twenty-seven27/CAN-NODE-BOARD/layout-bottom.png

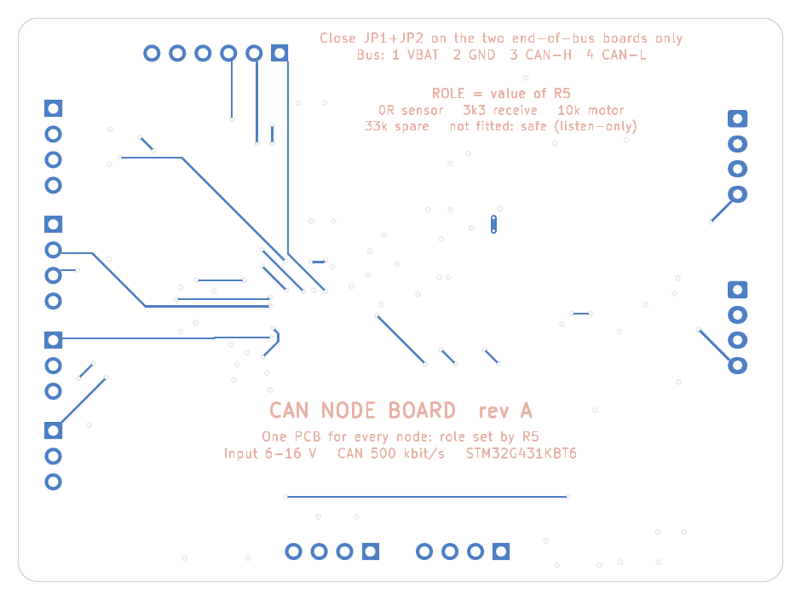
layout-bottom.png
