twenty-seven27/CAN-NODE-BOARD/layout-top.png

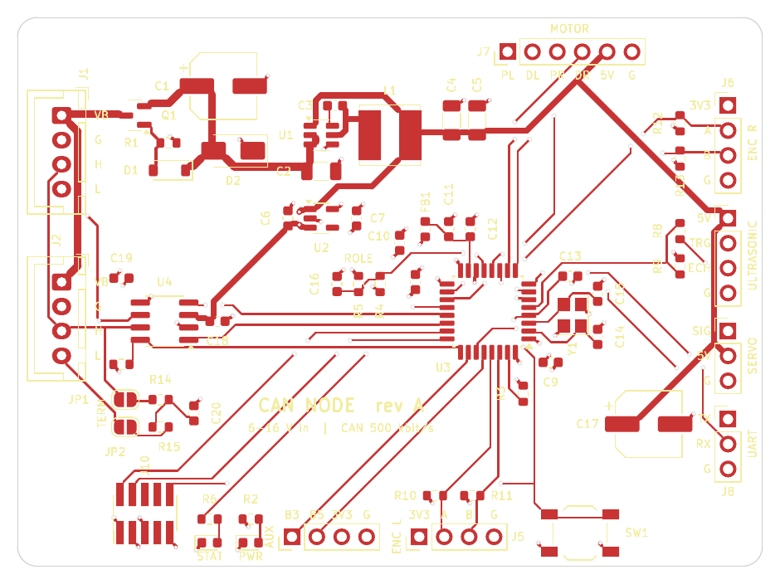
layout-top.png
