twenty-seven27/CAN-NODE-BOARD/schematic.pdf

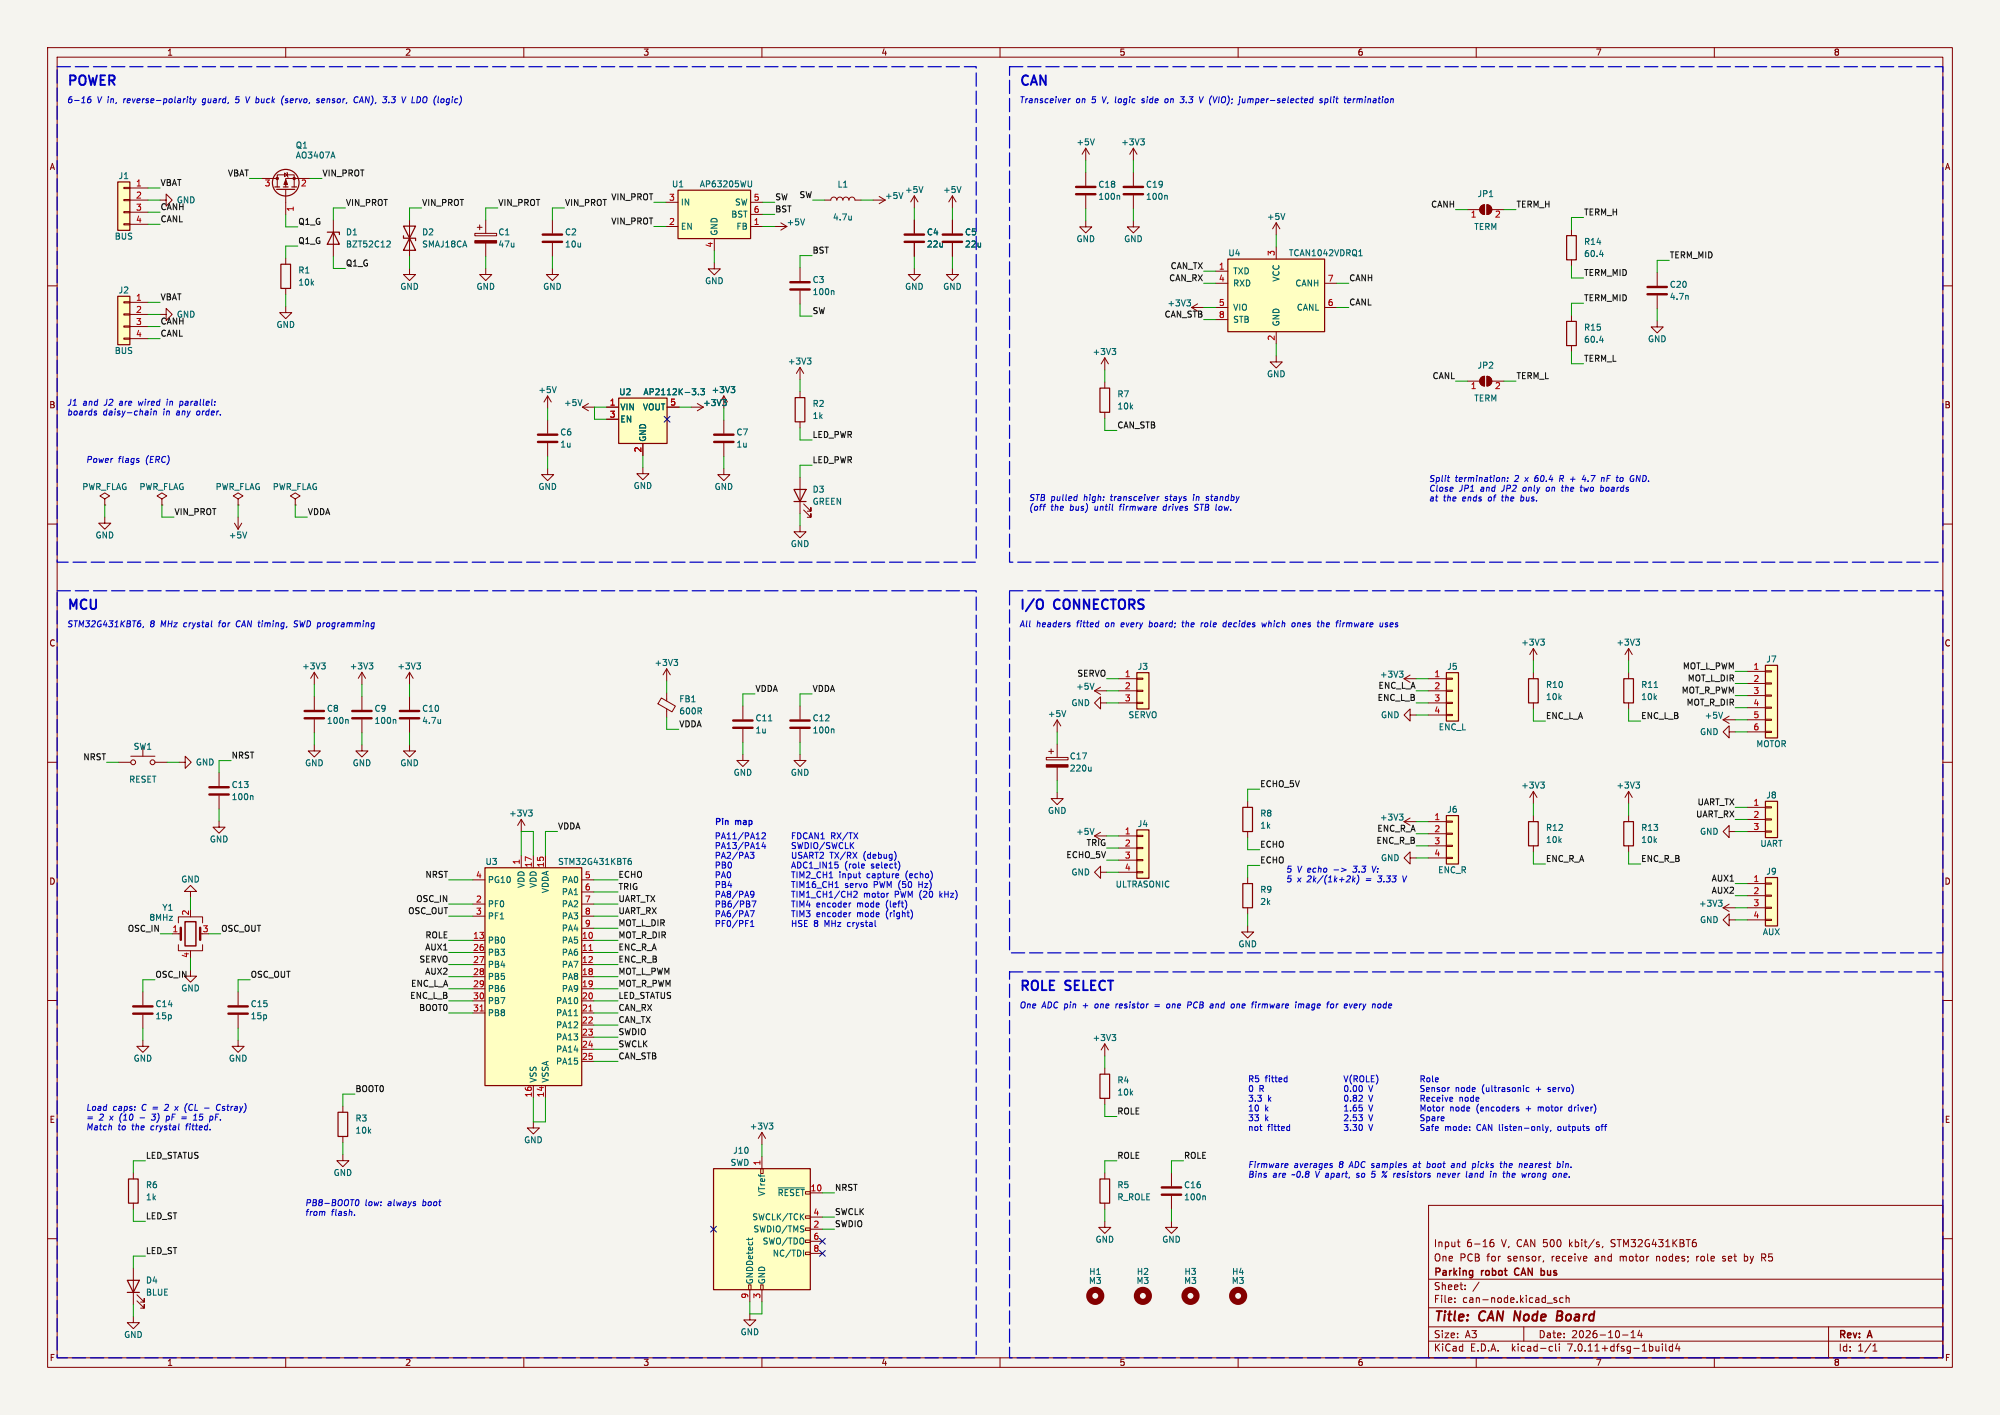
[picture p6: page 1]

3 RXD 4 VIO 5 CANL 6 CANH 7 STB 8 U4 TCAN1042VDRQ1 +3V3 R8

1 PA5 10 PA6 11 PA7 12 PB0 13 VSSA 14 VDDA 15 VSS 16 VDD 17 PA8 18 PA9 19 PF0 2 PA10 20 PA11 21 PA12 22 PA13 23 PA14 24 PA15 25 PB3 26 PB4 27 PB5 28 PB6 29 PF1 3 PB7 30 PB8 31 PG10 4 PA0 5 PA1 6 PA2 7 PA3 8 PA4 9 U3 STM32G431KBT6 GND

Load caps: C = 2 x (CL - Cstray) = 2 x (10 - 3) pF = 15 pF. Match to the crystal fitted.

3 SWCLK/TCK 4 SWO/TDO 6 NC/TDI 8 GNDDetect 9

Id: 1/1 Title: CAN Node Board
