twenty-seven27/CAN-NODE-BOARD/can-node.kicad_pcb

## KiCad design can-node.kicad_pcb (2026-10-15)

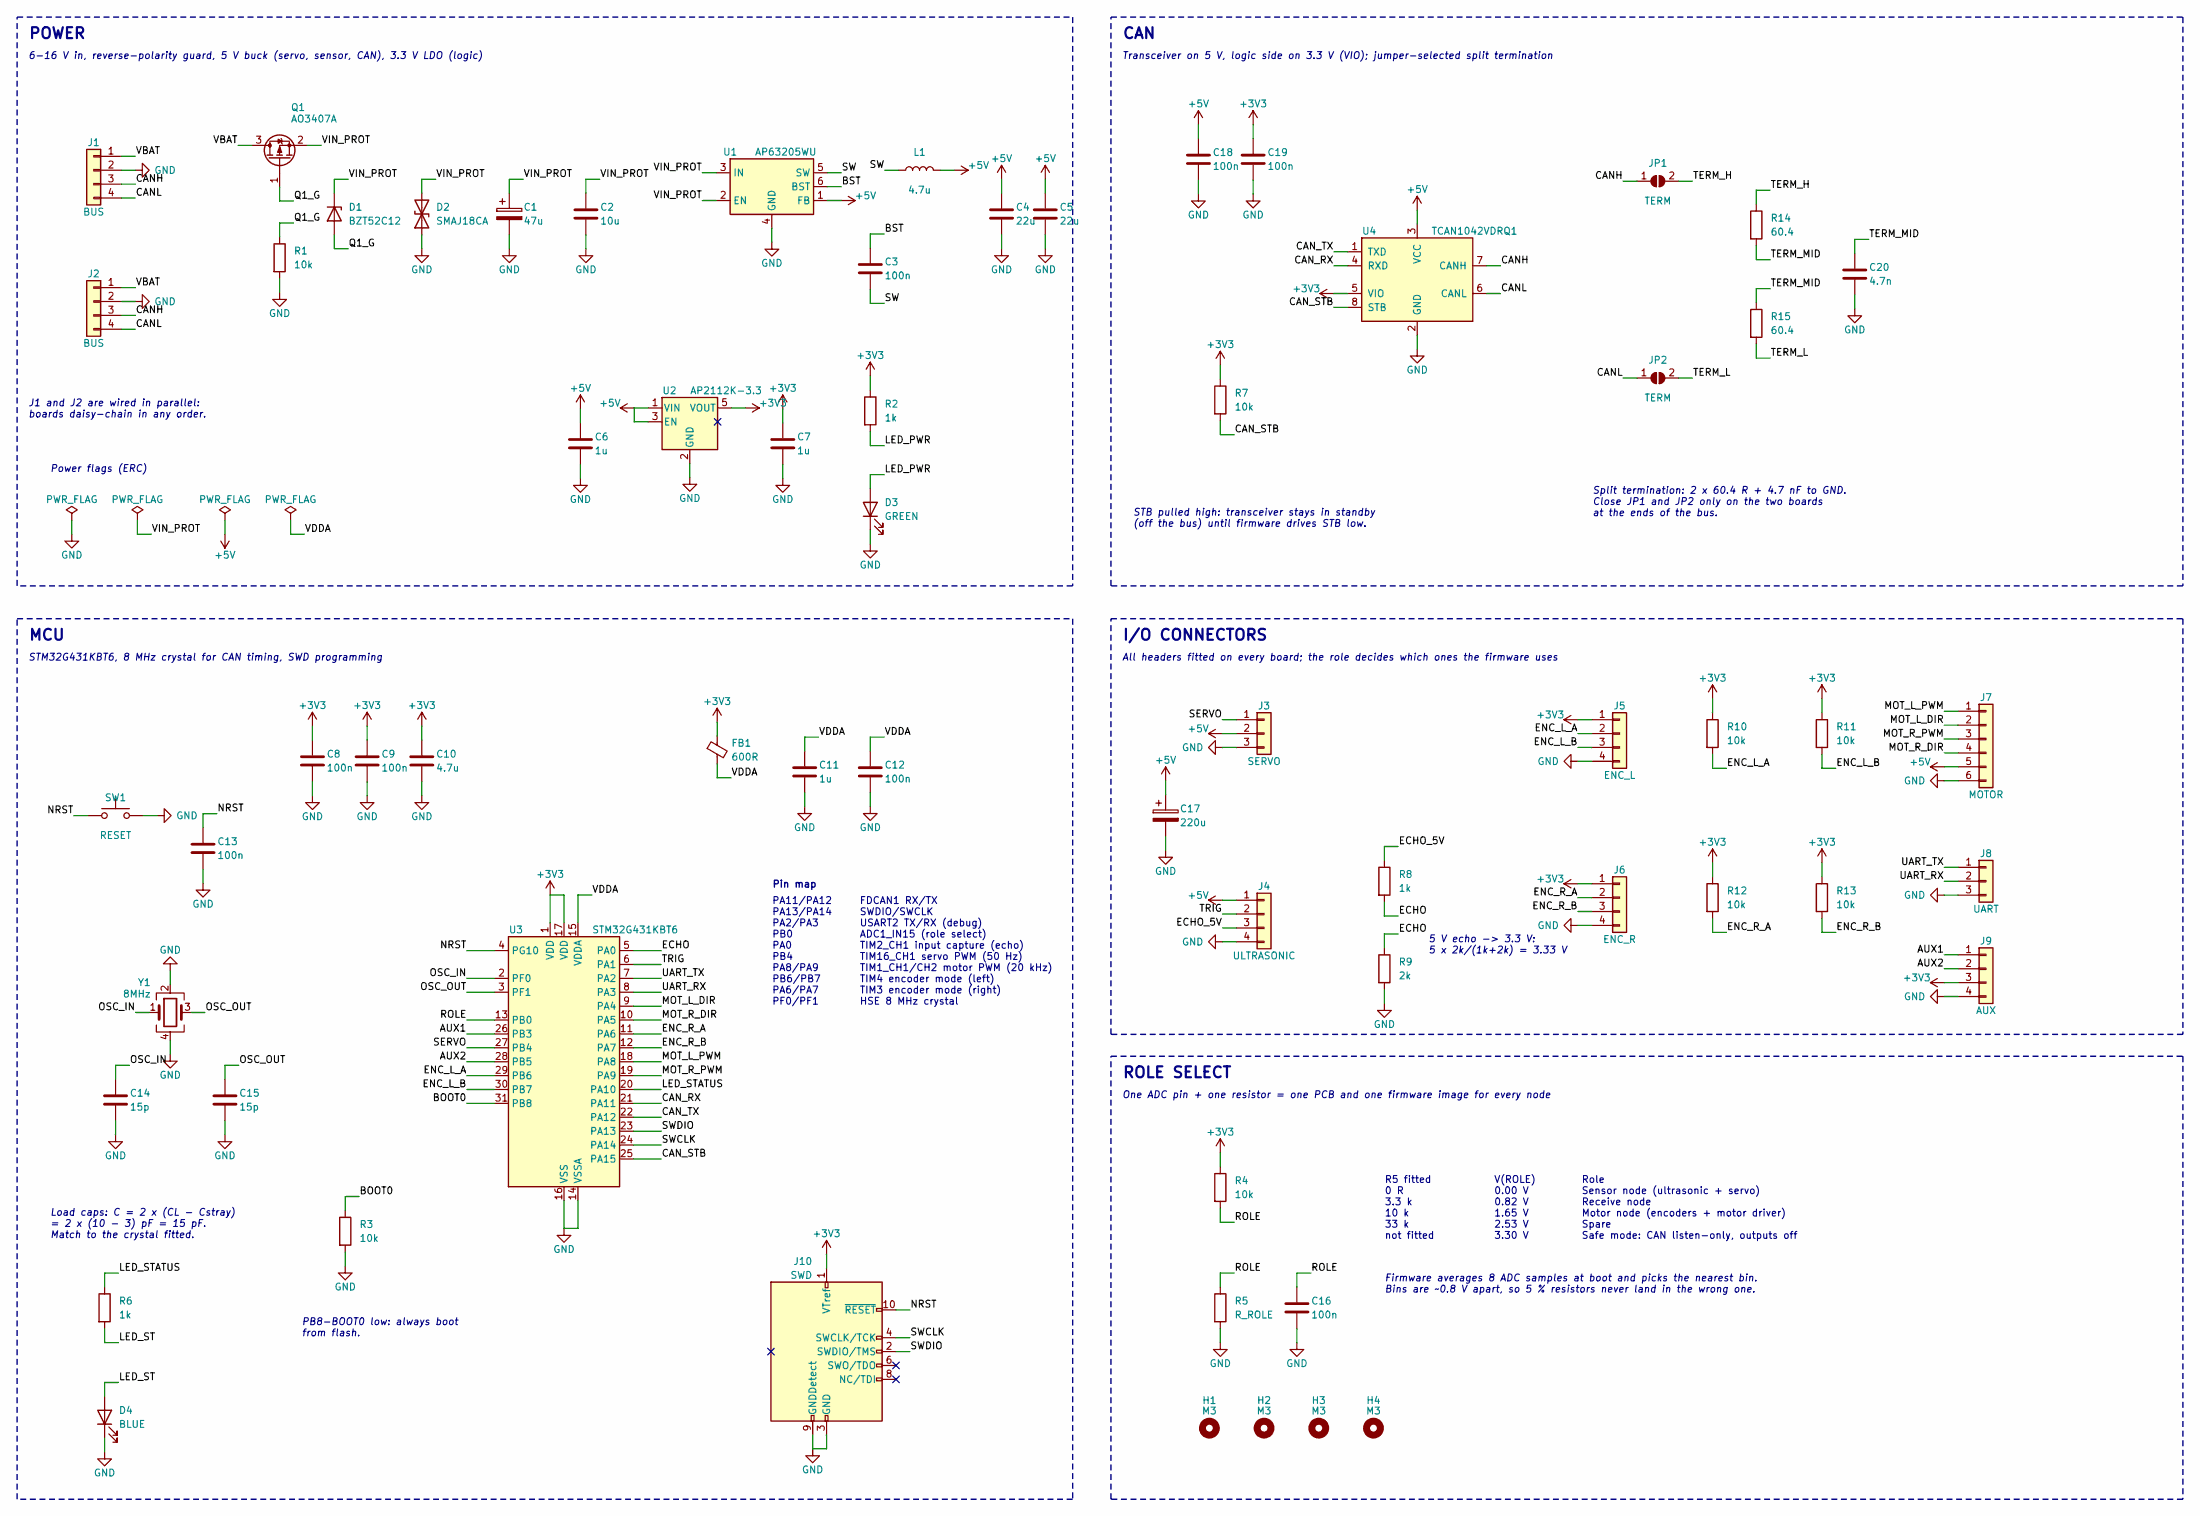
[picture p7: schematic can-node.kicad_sch, CAN Node Board]

Parts:
C1: 47u; CP_Elec_6.3x7.7; MPN Aluminium electrolytic 47 uF 35 V 6.3x7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
C2: 10u; C_1206_3216Metric; MPN X5R 10 uF 35 V 1206
C3, C8, C9, C12, C13, C16, C18, C19: 100n; C_0603_1608Metric; MPN X7R 100 nF 50 V 0603
C4, C5: 22u; C_1206_3216Metric; MPN X5R 22 uF 16 V 1206
C6, C7, C11: 1u; C_0603_1608Metric; MPN X7R 1 uF 16 V 0603
C10: 4.7u; C_0603_1608Metric; MPN X5R 4.7 uF 10 V 0603
C14, C15: 15p; C_0603_1608Metric; MPN C0G 15 pF 50 V 0603
C17: 220u; CP_Elec_6.3x7.7; MPN Aluminium electrolytic 220 uF 10 V 6.3x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
C20: 4.7n; C_0603_1608Metric; MPN C0G 4.7 nF 50 V 0603
D1: BZT52C12; D_SOD-123; MPN BZT52C12-7-F
D2: SMAJ18CA; D_SMA; MPN SMAJ18CA
D3: GREEN; LED_0603_1608Metric; MPN Green LED 0603
D4: BLUE; LED_0603_1608Metric; MPN Blue LED 0603
FB1: 600R; L_0603_1608Metric; MPN Murata BLM18AG601SN1D (600 R at 100 MHz)
H1, H2, H3, H4: M3; MountingHole_3.2mm_M3
J1, J2: BUS; JST_XH_B4B-XH-A_1x04_P2.50mm_Vertical; MPN JST B4B-XH-A
J3: SERVO; PinHeader_1x03_P2.54mm_Vertical; MPN 1x3 2.54 mm header
J4: ULTRASONIC; PinHeader_1x04_P2.54mm_Vertical; MPN 1x4 2.54 mm header
J5: ENC_L; PinHeader_1x04_P2.54mm_Vertical; MPN 1x4 2.54 mm header
J6: ENC_R; PinHeader_1x04_P2.54mm_Vertical; MPN 1x4 2.54 mm header
J7: MOTOR; PinHeader_1x06_P2.54mm_Vertical; MPN 1x6 2.54 mm header
J8: UART; PinHeader_1x03_P2.54mm_Vertical; MPN 1x3 2.54 mm header
J9: AUX; PinHeader_1x04_P2.54mm_Vertical; MPN 1x4 2.54 mm header
J10: SWD; PinHeader_2x05_P1.27mm_Vertical_SMD; MPN 2x5 1.27 mm SMD header (Cortex debug)
JP1, JP2: TERM; SolderJumper-2_P1.3mm_Open_RoundedPad1.0x1.5mm
L1: 4.7u; L_Bourns_SRN6045TA; MPN Bourns SRN6045TA-4R7M
Q1: AO3407A; SOT-23; MPN AO3407A
R1, R3, R7, R10, R11, R12, R13: 10k; R_0603_1608Metric
R2, R6, R8: 1k; R_0603_1608Metric
R4: 10k; R_0603_1608Metric; MPN 10k 1% 0603
R5: R_ROLE; R_0603_1608Metric; MPN per role table
R9: 2k; R_0603_1608Metric
R14, R15: 60.4; R_0603_1608Metric; MPN 60.4 ohm 1% 0603
SW1: RESET; SW_SPST_TL3342; MPN E-Switch TL3342F160QG
U1: AP63205WU; TSOT-23-6; MPN AP63205WU-7
U2: AP2112K-3.3; SOT-23-5; MPN AP2112K-3.3TRG1
U3: STM32G431KBT6; LQFP-32_7x7mm_P0.8mm; MPN STM32G431KBT6
U4: TCAN1042VDRQ1; SOIC-8_3.9x4.9mm_P1.27mm; MPN TCAN1042VDRQ1
Y1: 8MHz; Crystal_SMD_3225-4Pin_3.2x2.5mm; MPN 8 MHz 3225 crystal, CL = 10 pF, +/-20 p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

Connections:
+3V3: C7.1, C8.1, C9.1, C10.1, C19.1, FB1.1, J5.1, J6.1, J9.3, J10.1 (VTref), R2.1, R4.1, R7.1, R10.1, R11.1, R12.1, R13.1, U2.5 (VOUT), U3.1 (VDD), U3.17 (VDD), U4.5 (VIO)
+5V: C4.1, C5.1, C6.1, C17.1, C18.1, J3.2, J4.1, J7.5, L1.2, U1.1 (FB), U2.1 (VIN), U2.3 (EN), U4.3 (VCC)
/AUX1: J9.1, U3.26 (PB3)
/AUX2: J9.2, U3.28 (PB5)
/BOOT0: R3.1, U3.31 (PB8)
/BST: C3.1, U1.6 (BST)
/CANH: J1.3, J2.3, JP1.1 (A), U4.7 (CANH)
/CANL: J1.4, J2.4, JP2.1 (A), U4.6 (CANL)
/CAN_RX: U3.21 (PA11), U4.4 (RXD)
/CAN_STB: R7.2, U3.25 (PA15), U4.8 (STB)
/CAN_TX: U3.22 (PA12), U4.1 (TXD)
/ECHO: R8.2, R9.1, U3.5 (PA0)
/ECHO_5V: J4.3, R8.1
/ENC_L_A: J5.2, R10.2, U3.29 (PB6)
/ENC_L_B: J5.3, R11.2, U3.30 (PB7)
/ENC_R_A: J6.2, R12.2, U3.11 (PA6)
/ENC_R_B: J6.3, R13.2, U3.12 (PA7)
/LED_PWR: D3.2 (A), R2.2
/LED_ST: D4.2 (A), R6.2
/LED_STATUS: R6.1, U3.20 (PA10)
/MOT_L_DIR: J7.2, U3.9 (PA4)
/MOT_L_PWM: J7.1, U3.18 (PA8)
/MOT_R_DIR: J7.4, U3.10 (PA5)
/MOT_R_PWM: J7.3, U3.19 (PA9)
/NRST: C13.1, J10.10 (~RESET), SW1.1, U3.4 (PG10)
/OSC_IN: C14.1, U3.2 (PF0), Y1.1
/OSC_OUT: C15.1, U3.3 (PF1), Y1.3
/Q1_G: D1.2 (A), Q1.1 (G), R1.1
/ROLE: C16.1, R4.2, R5.1, U3.13 (PB0)
/SERVO: J3.1, U3.27 (PB4)
/SW: C3.2, L1.1, U1.5 (SW)
/SWCLK: J10.4 (SWCLK/TCK), U3.24 (PA14)
/SWDIO: J10.2 (SWDIO/TMS), U3.23 (PA13)
/TERM_H: JP1.2 (B), R14.1
/TERM_L: JP2.2 (B), R15.2
/TERM_MID: C20.1, R14.2, R15.1
/TRIG: J4.2, U3.6 (PA1)
/UART_RX: J8.2, U3.8 (PA3)
/UART_TX: J8.1, U3.7 (PA2)
/VBAT: J1.1, J2.1, Q1.3 (D)
/VDDA: C11.1, C12.1, FB1.2, U3.15 (VDDA)
/VIN_PROT: C1.1, C2.1, D1.1 (K), D2.2 (A2), Q1.2 (S), U1.2 (EN), U1.3 (IN)
GND: C1.2, C2.2, C4.2, C5.2, C6.2, C7.2, C8.2, C9.2, C10.2, C11.2, C12.2, C13.2, C14.2, C15.2, C16.2, C17.2, C18.2, C19.2, C20.2, D2.1 (A1), D3.1 (K), D4.1 (K), J1.2, J2.2, J3.3, J4.4, J5.4, J6.4, J7.6, J8.3, J9.4, J10.3 (GND), J10.5 (GND), J10.9 (GNDDetect), R1.2, R3.2, R5.2, R9.2, SW1.2, U1.4 (GND), U2.2 (GND), U3.14 (VSSA), U3.16 (VSS), U3.32 (VSS), U4.2 (GND), Y1.2, Y1.4

Notes on the sheet:
POWER
6-16 V in, reverse-polarity guard, 5 V buck (servo, sensor, CAN), 3.3 V LDO (logic)
J1 and J2 are wired in parallel: boards daisy-chain in any order.
Power flags (ERC)
CAN
Transceiver on 5 V, logic side on 3.3 V (VIO); jumper-selected split termination
STB pulled high: transceiver stays in standby (off the bus) until firmware drives STB low.
Split termination: 2 x 60.4 R + 4.7 nF to GND. Close JP1 and JP2 only on the two boards at the ends of the bus.
MCU
STM32G431KBT6, 8 MHz crystal for CAN timing, SWD programming
Pin map
PA11/PA12 PA13/PA14 PA2/PA3 PB0 PA0 PB4 PA8/PA9 PB6/PB7 PA6/PA7 PF0/PF1
FDCAN1 RX/TX SWDIO/SWCLK USART2 TX/RX (debug) ADC1_IN15 (role select) TIM2_CH1 input capture (echo) TIM16_CH1 servo PWM (50 Hz) TIM1_CH1/CH2 motor PWM (20 kHz) TIM4 encoder mode (left) TIM3 encoder mode (right) HSE 8 MHz crystal
Load caps: C = 2 x (CL - Cstray) = 2 x (10 - 3) pF = 15 pF. Match to the crystal fitted.
PB8-BOOT0 low: always boot from flash.
I/O CONNECTORS
All headers fitted on every board; the role decides which ones the firmware uses
5 V echo -> 3.3 V: 5 x 2k/(1k+2k) = 3.33 V
ROLE SELECT
One ADC pin + one resistor = one PCB and one firmware image for every node
R5 fitted 0 R 3.3 k 10 k 33 k not fitted
V(ROLE) 0.00 V 0.82 V 1.65 V 2.53 V 3.30 V
Role Sensor node (ultrasonic + servo) Receive node Motor node (encoders + motor driver) Spare Safe mode: CAN listen-only, outputs off
Firmware averages 8 ADC samples at boot and picks the nearest bin. Bins are ~0.8 V apart, so 5 % resistors never land in the wrong one.

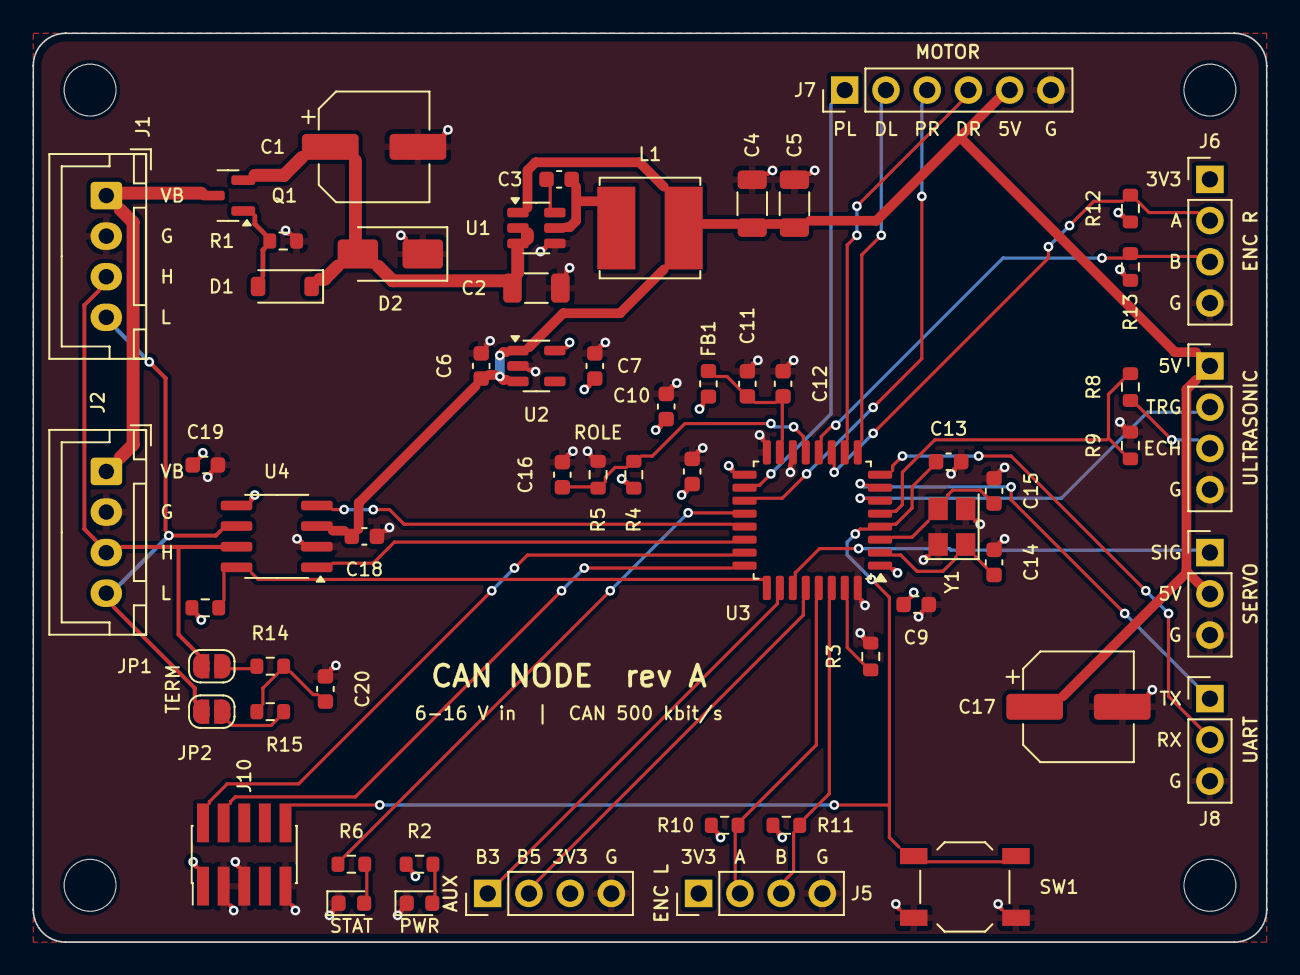
[picture p8: board can-node.kicad_pcb from above]

Board: 4 copper layers, 76.0 x 56.0 mm, 64 parts (0 on the bottom side), 43 nets.
